Steven-ZYC/int4089-fitness-aid-bot/README.md

<div align="center">

FitCoach AI — Move better. Train smarter.

<br />

[English](README.md) · [简体中文](README_zh_cn.md) · [繁體中文（香港）](README_zh_hk.md)

<br /><br />

**Your movement. Your feedback. Your progress.**

A modular, PC-powered AI fitness coaching prototype built for **INT4089 — Technologies in STEM and AI Education**.

    

**[✨ Features](#features) · [🧭 Architecture](#architecture) · [🚀 Quick start](#quick-start) · [📖 User manual](docs/guide/README.md)**

</div>

---

## Product preview

<div align="center">
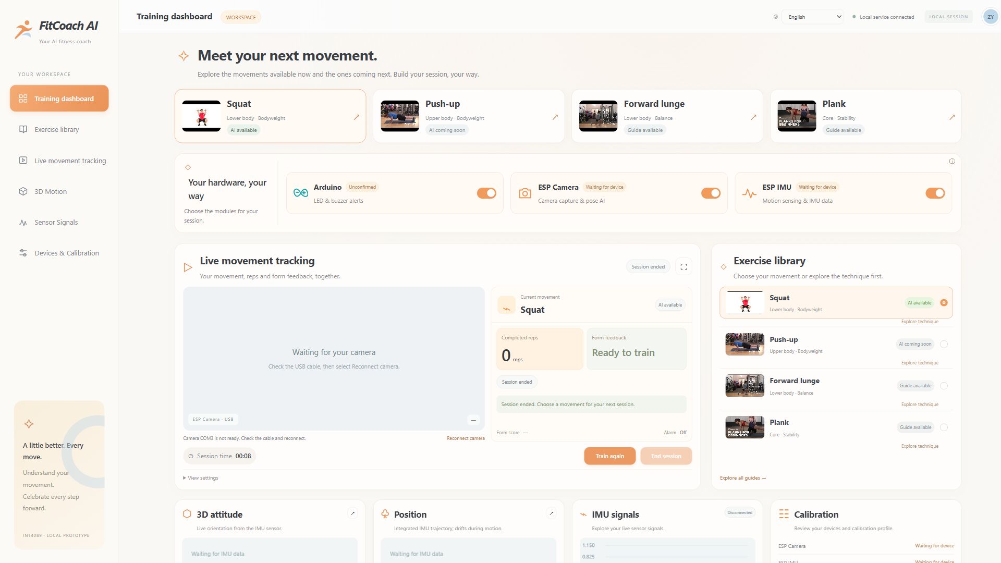
[picture p1: docs/assets/fitcoach-ui-en-16x9.png]
FitCoach AI real application screenshot

<br />
<sub>Actual application screenshot · hardware state shown is not simulated</sub>
</div>

## What you can do

| | Experience | Current implementation |
| :---: | --- | --- |
| 🎯 | **AI squat coaching** | YOLOv8n-pose keypoints, rule-based form feedback, repetition counting and session control |
| 🎬 | **Movement learning library** | Six exercise guides with video previews, step-by-step cues and posture illustrations; **Squat is the only AI-enabled movement** |
| 🎛️ | **Modular hardware configuration** | Independently enable or disable **Arduino alerts**, **ESP Camera**, and **ESP IMU** at the app level |
| 🧭 | **3D orientation & position** | 3D attitude display, motion trace and position reset; displacement is an estimate subject to drift |
| 📈 | **IMU analysis & calibration** | Signal charts, labeled CSV replay, calibration profiles and diagnostics |
| 🌐 | **Multilingual UI** | English, Simplified Chinese and Traditional Chinese (Hong Kong) |

> [!IMPORTANT]
> **Prototype, not a finished fitness product.**

### Movement library

| AI coaching available | Teaching preview / AI planned |
| --- | --- |
| ✅ **Squat** | Push-up · Forward lunge · Plank · Glute bridge · Bird dog |

### Mix the hardware you need

| Module | Role | Can operate independently? |
| --- | --- | --- |
| **ESP Camera** (ESP32-CAM / OV2640) | Captures JPEG frames and sends them to the PC over USB | Camera-based squat coaching does not require live IMU data |
| **ESP IMU** (ESP32-S3 N16R8 + BMI160) | Acquires inertial signals for monitoring and analysis | IMU monitoring/replay may be viewed without camera-based coaching; live BMI160 is pending validation |
| **Arduino alerts** | Drives LED and buzzer from received alarm state | Switchable; **physical alarm delivery** needs the complete CAM → S3 → Arduino path |

App toggles do **not** cut hardware power.

## 🧭 Architecture

```mermaid
flowchart LR
    U([Workout]) --> CAM[ESP32-CAM<br/>OV2640 Camera]
    CAM -->|JPEG frames over USB| PC[PC<br/>YOLOv8n-pose + form rules]
    PC -->|Alarm state over USB| CAM
    CAM <-->|ESP-NOW: alarm + ACK only| S3[ESP32-S3 N16R8]
    IMU[BMI160 IMU] -->|I²C| S3
    S3 -->|One-way UART| Arduino[Arduino]
    Arduino --> LED[LED + Buzzer]
    classDef compute fill:#f9eedb,stroke:#eb9861,color:#303a40;
    classDef sensor fill:#eaf3f8,stroke:#bdd6e8,color:#303a40;
    class PC,Arduino compute;
    class CAM,S3,IMU sensor;
```

**The camera stream is USB-based. ESP-NOW transports only compact alarm commands/acknowledgements—never images.** AI inference runs on the PC, not on the ESP32. Cloud/HPC execution is a future possibility, not a deployed feature.

## 🚀 Quick start

**Requirements:** Windows PowerShell, the project's configured Python virtual environment, and the connected camera board. Serial ports are machine-specific.

```powershell
# From the repository root
powershell.exe -NoProfile -ExecutionPolicy Bypass -File app/run_pose.ps1 -CamPort COM3 -ImuPort COM4 -Action squat
```

Open **http://127.0.0.1:8010**, confirm device status, select **Squat**, align the camera and choose **Start training**. Use `-ImuPort ''` to skip initial IMU connection. `-Action squat` is the only AI action supported by the unified application.

For fresh installation and manual launch options, follow the [PC app guide](app/README.md) and [unified app guide](app/UNIFIED_APP.md). Do not run firmware upload, serial diagnostic and the dashboard against the same COM port simultaneously.

## 🧪 Evidence & current limitations

| Status | Result / validation boundary |
| --- | --- |
| ✅ | Real USB image CRC/decoding and PC pose inference |
| ✅ | Wireless alarm state / ACK / command-expiry tests |
| ✅ | **8.93 FPS** camera USB-only benchmark (not a guaranteed AI end-to-end rate) |
| 🛠️ | BMI160 live data not yet stable; physical alarm output and exercise accuracy require on-device acceptance |

See the [test evidence](docs/validation/2026-11-10-camera-speed-after.json) and [system architecture](docs/architecture/README.md). Position double-integration may drift; yaw lacks an absolute magnetometer reference.

## 📖 Documentation

- [**Illustrated assembly guide / user manual**](docs/guide/README.md) · [English user manual (PDF)](docs/guide/fitcoach-user-manual.pdf)
- [PC application & training workflow](app/UNIFIED_APP.md)
- [Firmware and hardware connections](firmware/README.md)
- [System architecture & protocols](docs/architecture/README.md) · [Documentation index](docs/README.md)
- [Maintenance and contributor rules](AGENTS.md)

<details><summary><strong>Repository layout</strong></summary>

```text
app/                  # Local web app, computer-side pose inference and IMU service
firmware/             # ESP32-CAM, ESP32-S3, Arduino and protocol implementations
models/               # Model tasks and research notes
experiments/          # Historical on-board inference benchmarks
tools/imu-position/   # IMU acquisition, calibration and visualization
docs/                 # Assembly guide, architecture, screenshots and validation
AGENTS.md             # Branch and maintenance rules
```

</details>

---

<div align="center"><sub>FitCoach AI · INT4089 · The Education University of Hong Kong<br/>Built as an educational engineering prototype — designed to help learners understand movement and sensing.</sub></div>
