Steven-ZYC/int4089-fitness-aid-bot/models/README_zh_cn.md

# AI 模型与电脑端分析（Prototype）

负责人：**Zhang Haoyu**；专属分支：**`Feat-Arduino-Haoyu`**（历史分支名，当前任务不以 Arduino 固件为主）。

开始前阅读根目录 [AGENTS.md](../AGENTS.md)，确认身份、本人分支及工作区状态。只在本人分支修改提交；用 PR 申请合并到 `main`。

## 最新任务（2026-10-30 consultation 后）

**AI 推理暂时在团队电脑上运行，不要求把模型部署在 ESP32 上。** 数据由 Dong Yuankun 的双 ESP32 系统提供：ESP32-CAM 采集图像，ESP32-S3 主 ESP 采集 Bosch BMI-series IMU 的运动数据，并负责与电脑的网络通信。

此目录应逐步形成可复现的**数据集选择 → 训练／验证 → 电脑端推理 → 姿势结果输出**流程。未来若原型验证可行，可再考虑迁移至云端 HPC／GPU 服务器；目前不得写成已上线。

## 当前交付要求

1. **任务定义**：先明确要支持的健身动作、姿势异常的判定标准、模型输出（关键点／动作类别／错误类型等）和可观测评价指标；不要只以“人体姿态检测”笼统代替“动作是否标准”。
2. **数据集调查与选型**：对比候选数据集的动作覆盖、姿势标注、许可、规模、可用性及数据质量；记录下载／标注流程、训练／验证／测试划分，避免数据泄漏。无法直接支持姿势正误识别的数据集须说明补标或迁移方案。
3. **模型训练与验证**：建立最低可用 baseline，保存版本、环境、超参数、预处理与验证结果；如尚未跑通就标明未训练，不预报准确率。
4. **电脑端推理服务**：编写可在团队电脑运行的图像输入、推理、后处理与结果输出流程。和 Yuankun 确认网络消息格式及摄像头帧、IMU 时间戳的数据接口。
5. **融合策略与指标**：明确第一版使用图像 alone 还是图像 + IMU 融合；如果融合未实现，需明确标记。记录模型级时延、有效帧率及与系统集成相关的端到端延迟。
6. **交付集成**：给出判断结果的数据结构（含动作、时间戳、置信度／阈值、反馈类型等可用字段）、测试样例与运行说明，让 Yancheng 可以对接 Arduino 的 LED／蜂鸣器提醒。

## 协作接口

- 与 **Dong Yuankun**：约定图像输入格式、IMU 单位和坐标系、时间戳、传输速率／容错、电脑侧接收方法。
- 与 **Zhang Yancheng**：确认原型范围、系统接口与测试场景；输出“姿势正常／需要提醒”等结构化消息供硬件闭环使用。
- 历史 ESP32-S3 板上部署与 RDK X5 NPU 不再是本阶段的交付要求。

本文件是任务说明，**不代表已选定数据集、训练成功、验证模型性能或完成电脑端服务**。不提交可辨识的人像、未授权数据或凭据；模型权重和训练数据根据项目忽略规则及许可管理。
