Steven-ZYC/int4089-fitness-aid-bot/firmware/arduino-uno/README_zh_cn.md

# Arduino：LED 与蜂鸣器

任务状态：**保留的 Arduino 基础控制说明**。

原负责人为 **Zhang Haoyu**；其当前重点已转为[模型训练研究](../../models/README.md)，本文件不再代表他的当前首要任务。
后续硬件任务分工由 Zhang Yancheng 统筹。

历史任务分支：**`Feat-Arduino-Haoyu`**（大小写必须一致）；该分支目前继续用于 Haoyu 的模型训练研究。

开始前先读仓库根目录 `AGENTS.md`，明确确认当前用户身份，并检查当前分支。
身份不明时必须先询问；只有确认本人及专属分支后才能开始修改。
本任务只在自己的分支修改、提交和推送，禁止直接向 `main` 或其他成员分支提交。

## 保留的硬件目标

使用 **Arduino** 接好 LED 和蜂鸣器，并能分别进行基础控制。
本目录目前是任务说明，尚未提供或验证固件与接线。

## 交付与验收

1. 提交清晰的接线记录：器件、实际引脚、电源／地线、必要元件及接线照片或示意图。
2. 提交可烧录的最小示例：LED 能亮灭，蜂鸣器能按指令响起并停止。
3. 记录板上实际运行结果，让其他成员按步骤能够复现。
4. 明确标注哪些内容已实测、哪些仍待确认；不要把预期效果写成实测结果。

## 随交付记录

- 实际 Arduino 板卡型号／版本、LED 类型与蜂鸣器类型。
- 完整引脚映射、供电方式及实际使用的电阻等元件。
- Arduino IDE 版本、开发板选择、板卡包版本及上传端口选择方法。
- 所需库及版本；无额外库时明确写明。
- 从打开工程、编译、烧录到操作 LED／蜂鸣器的复现步骤。
- 已观察到的表现、失败现象和排查方法。

硬件型号、引脚、电压或器件类型尚未确认时，先记录待确认项，不得猜测接线。
Arduino 负责本地 LED／蜂鸣器控制，需与 **ESP32-CAM** 建立硬件连接；另一块 **ESP32-S3 N16R8** 规划作为连接 Bosch BMI-series IMU 和电脑网络的主 ESP。**AI 训练与推理现阶段在团队电脑上进行**，将来原型有效后才考虑云端 HPC。具体 AI 判断结果返回 Arduino 的链路、引脚和电气设计仍待集成验证；旧的 ESP32-S3 板上推理与 RDK X5 方案已不是当前主线。
不要提交 Wi-Fi 密钥、凭据或含可识别人像的照片。
