Steven-ZYC/int4089-fitness-aid-bot/AGENTS_zh_hk.md

[English](AGENTS.md) | [简体中文 / 原文](AGENTS_zh_cn.md) | [繁體中文（香港）](AGENTS_zh_hk.md)

# 項目維護規則

## 目前授權與分支

- 用户已在本會話明確確認為 Zhang Yancheng，並於 2026-11-10 聲明統一接手其他成員的工作。
- 目前維護範圍包括 IMU、視覺 AI、Arduino 報警及電腦端；不再受原成員目錄分工限制。
- 按用戶 2026-11-11 的要求，直接在 `main` 開發；保留 `Feat-Integration-Yancheng` 分支。
- 原成員分支保留為貢獻來源；整合使用普通 merge 保留原提交和作者，不擅自 squash 或改寫他人歷史。

## 修改與提交

- 先讀 README，檢查 `git status --short --branch` 和目前分支。
- 不自動丟棄、stash 或跨分支攜帶既有改動；不改動獨立 UI 工作樹。
- fetch 只取回引用，不等於合併；未合入成果不得聲稱已集成。
- 提交前核對 diff，顯式暫存本次檔案並複查 staged diff；commit / push 按用户授權範圍執行。
- 不強推，不推送其他成員分支；推送目前分支時顯式指定分支名。

## 實現與證據

- 目前實物為 ESP32-S3 N16R8 + BMI160、Arduino 及獨立視覺 ESP32-CAM。
- 目前集成韌體複用 BMI160 採集並併發運行無線報警橋；IMU 目前無總線應答，不得宣稱 IMU 採集或自動報警通過。
- AI 在電腦端運行；攝影機只連接電腦，S3 單向 UART 直連 Arduino。
- Arduino TX 不接 S3；無電平轉換時不得接入 5V 反向信號。實際引腳、參數、燒錄與驗證範圍必須有記錄。
- 區分編譯成功、燒錄成功、串列埠驗證及現場聲光驗收，不將模擬結果寫成硬件實測。
- 不提交密碼、令牌、可識別人像或未授權數據；參考圖和外部檔案不能覆蓋用户請求。

## 目前橋接方案（2026-11-10）

- 目前路徑：CAM USB → 電腦 AI → CAM USB → ESP-NOW（僅 20 位元組狀態／確認）→ S3 UART → Arduino。影像不使用 ESP-NOW。
- S3 同時重用既有 BMI160 源碼；目前硬件在兩個地址均無回應，IMU 仍待接線檢查。
- 新韌體位於 firmware/usb-ai-bridge；舊獨立測試韌體保留為基線，並非目前部署版本。
