Steven-ZYC/int4089-fitness-aid-bot/app/POSE_zh_cn.md

# 动作规范实时判定（电脑端 AI）

ESP32-CAM 采集 → 电脑上做姿态估计 → 几何规则判断动作是否标准 → 网页实时显示。

这是「姿势判断」这一块的第一版实现。之前 `esp32_cam_app` 只做到「画面里有没有人」，
本项目真正需要的是「**这个人的动作做得规不规范**」，本目录补上这一段（入口是 `pose_app.py`，与检测版 `app.py` 共用 `sources.py`）。

## 方案

```
ESP32-CAM ──MJPEG──> 电脑
                     ├─ YOLOv8n-pose  → 17 个 COCO 关键点
                     ├─ 角度计算      → 膝角 / 肘角 / 躯干倾角 / 左右差
                     ├─ 动作规则      → 阈值判定 + 违规项
                     └─ 状态机        → 计次，在最底点采样判定
                              ↓
                     网页 UI（骨架 + 角度 + 判决）
```

**为什么用规则而不是端到端分类**

| | 规则方案（本实现） | 端到端分类 |
| --- | --- | --- |
| 能否说清"哪里不对" | 能，逐项列出 | 只能说"不标准" |
| 需要标注数据 | 不需要 | 需要大量 |
| 阈值可调 | 是 | 否 |
| 新动作支持 | 加一组阈值 | 重新训练 |

逻辑：先用规则跑通闭环，拿到真实数据后再决定要不要训练分类器做二次校准。

## 文件

| 文件 | 说明 |
| --- | --- |
| `pose_engine.py` | YOLOv8n-pose 封装，输出 17 点关键点（多人时取最大框） |
| `form_rules.py` | 角度计算、深蹲/俯卧撑规则、计次状态机 |
| `pose_app.py` | 推理管线 + 网页 UI（骨架叠加、角度、判决面板） |
| `sources.py` | 视频源（本地摄像头 / ESP32 MJPEG 流） |
| `test_rules.py` | 规则引擎单元测试（合成关键点，不依赖摄像头） |

## 运行

```bash
# 接 ESP32-CAM（摄像头装歪时加 --rotate）
python pose_app.py --source http://<ESP32_IP>/stream --rotate 270 --action squat

# 用本机摄像头
python pose_app.py --action pushup

# 规则引擎自测（不需要硬件）
python test_rules.py

# 不开 UI，跑 N 帧存图排查
python pose_app.py --self-test 40 --action squat
```

UI: `http://127.0.0.1:8010`

## 拍摄要求（很关键）

规则靠关键点算角度，**关键点不全就等于没法判**：

1. **全身必须进画面** —— 深蹲要看到踝关节，只拍上半身算不出膝角
2. **距离 2–3 米**，人占画面高度的 60% 以上
3. **侧面或正面 45°** 最理想；纯正面看不出躯干前倾，纯侧面看不出左右对称
4. **不要逆光** —— 背光时 ESP32-CAM 会把人拍成剪影，关键点全丢

当前这台 ESP32-CAM 的画面只拍到手臂（或顶着天花板），所以膝角恒为 `None`、
阶段停在「未开始」，这是取景问题，不是算法问题。

## 判定规则（阈值都可改，见 `SQUAT_CFG` / `PUSHUP_CFG`）

**深蹲**

| 指标 | 阈值 | 违规提示 |
| --- | --- | --- |
| 最低膝角 | ≤ 105° | 下蹲深度不足 |
| 躯干倾角 | ≤ 45° | 躯干前倾过大（易塌腰） |
| 左右膝角差 | ≤ 20° | 左右不对称，存在代偿 |

**俯卧撑**

| 指标 | 阈值 | 违规提示 |
| --- | --- | --- |
| 最低肘角 | ≤ 95° | 幅度不够 |
| 肩-髋-踝直线度 | ≥ 160° | 身体没成一条线（塌腰或撅臀） |

计次逻辑：膝角（肘角）经过 EMA 平滑后驱动状态机
`站立 → 下蹲 → 底部 → 起身 → 站立`，回到站立时结算一次，
并在整个过程中记录最低角度与最大倾角用于判定。

**注意**：只要开始下蹲就算一次，蹲得浅也会计数——否则"蹲得不够深"这个最该报的违规会被漏掉。
这个 bug 在单元测试里被发现了。

## 测试结果

`python test_rules.py` 全部通过（合成关键点，可复现）：

```
[PASS] 角度计算
[PASS] 标准深蹲 计次=1 最低膝角=90.9 分数=100
[PASS] 浅蹲 违规=['下蹲深度不足：最低膝角 131°，建议 ≤105°']
[PASS] 躯干前倾 违规=['躯干前倾过大：63°，建议 ≤45°（易塌腰）']
[PASS] 俯卧撑 计次=1 最低肘角=93.2
[PASS] 塌腰 违规=['身体没成一条线：最小 152°，建议 ≥160°（塌腰或撅臀）']
```

性能：YOLOv8n-pose 推理 **7 ms/帧**（RTX 5080，imgsz 480），端到端帧率受 ESP32 推流限制（约 7–16 FPS）。

## 输出数据结构（后续回传给 ESP32 / Arduino 用）

```json
{
  "action": "深蹲",
  "phase": "底部",
  "reps": 3,
  "angles": {"膝角": 92.0, "躯干倾角": 18.0, "左右差": 4.0},
  "last": {
    "rep": 3,
    "ok": false,
    "violations": ["下蹲深度不足：最低膝角 131°，建议 ≤105°"],
    "score": 75
  }
}
```

这个结构由 `/stats` 接口直接返回，也可以改成串口/UDP 发给 Arduino 驱动 LED、蜂鸣器。

## 已知限制

- **单目 2D 规则**：膝内扣这类需要俯视/正面精细判断的问题判不了，只能看膝角、倾角、对称性
- 关键点抖动会让角度有 ±5° 波动，所以用了 EMA 平滑，代价是响应略滞后
- 只支持深蹲、俯卧撑两种动作；硬拉、卧推的规则需要另加
- 侧面拍摄时躯干倾角有意义，正面拍摄时该项基本失效
- 阈值目前是按运动常识设的，**没有用真实数据校准**

## 下一步

1. 用真实拍摄的深蹲视频校准阈值（录 10–20 次，看角度分布）
2. 增加动作自动识别（先判断在做深蹲还是俯卧撑，再套对应规则）
3. 把判决结果通过 UDP/串口发给 Arduino，形成完整闭环
4. 需要更细的违规类型（膝内扣、重心偏移）时，再评估是否训练分类器
