Steven-ZYC/int4089-fitness-aid-bot/firmware/esp32-camera/PROGRESS.md

# Yuankun 任務與進度

更新日期：2026-11-05。分支：`Feat-Esp-Yuankun`。本次成果交接見 [HANDOFF.md](HANDOFF.md)；Git 提交與遠端版本以分支記錄為準。

**歷史第 1–4 步及 11-04 的 Normal 並發檢查已通過；第 5 步未完成，IMU 排查已請組長接手。** 11-05 網關版的專用 Wi-Fi／TCP 控制 5 次及空閒重連後 1 次回覆通過，見 [網絡結果](WIFI_GATEWAY_RESULT.md)；照片／IMU 的 Wi-Fi 傳輸未測。之後 IMU 初始化故障，早期身份可讀但喚醒陀螺儀寫入失敗；用戶最新重新接線後，網關版連最初的身份讀取亦未成功。完整斷電及 100ms 等待測試未恢復，詳見 [IMU 排查](BMI160_RECOVERY.md)。

**目前板上版本：** BMI160_Bus_Check_v1 獨立診斷程式，編譯／上傳校驗及 COM9 的版本讀回通過。用戶已按正面位置確認 VIN 留空、六線全部吻合；16:09 三輪探測在 0x68／0x69 均無應答，身份讀取失敗，停在 INITIAL_ID，尚未執行重設／加速度計／陀螺儀配置寫入，沒有六軸資料。詳見 [分段診斷](BMI160_BUS_DIAG.md) 及 [最新排查](BMI160_RECOVERY.md)。原成功映像及網關來源保留，現在未運行網關。根因未確認，不能直接判定接線錯誤或模組損壞；本輪未切換電腦網絡或刷寫 CAM。

## 器材盤點

| 器材 | 已知證據 | 待確認 |
| --- | --- | --- |
| ESP32-S3-N16R8 主板 | 16MB Flash／8MB PSRAM 自檢、IMU 基線通過；COM9／CH340 的 ESP-NOW 文字、圖片重組及 USB 導出通過 | 長時間 IMU／圖片並發及網絡；原生 USB 無輸出原因未定位，未做全容量記憶體壓力測試 |
| 舊 ESP32-CAM | COM11 的 OV2640／4MB Flash／2MB PSRAM、新幀檢查、ESP-NOW 文字及三個圖片案例通過 | 固定取景、畫質／長時間測試、長時間 IMU 並發採集 |
| 紫色 BMI160 標示模組 ×1 | 身份、六軸靜止／運動、照片參考加速度方向、順時針負 Z、獨立零偏驗證；多段實測約 49.73 Hz | X／Y 角速度各自的定向標定、加速度多姿態／比例／溫度校準、長時間穩定性；無廠商資料，未量測電壓與上拉阻值 |
| 藍色 GY-801 ×3 | 新照片和你提供的數量 | 備用；未逐塊驗證晶片型號或讀值 |
| Arduino 與提醒器件 | 組長架構要求 | 是否在手邊、具體通信／電平轉換及控制接線 |
| 接線用品 | 你確認有杜邦線和麵包板 | 按實物接點選可牢固插接的線材 |

## 任務清單與完成條件

| 步驟 | 狀態 | 做甚麼、為甚麼 | 甚麼證據才可標完成 |
| --- | --- | --- | --- |
| 0 | **已完成：盤點與選型** | 按現有器材選紫色 BMI160；圖像與 AI 分工保持組長新方案 | 照片／數量已記錄，[選型理由](IMU_SELECTION.md) 已寫明；不代表電路已測 |
| 1 | **已完成：基本自檢** | 新 S3 獨立自檢，先確保主控可燒錄與輸出資料 | COM9 確認 S3、寫入校驗通過、兩次週期報告讀回 16MB／8MB，見 [實測結果](S3_TEST_RESULT.md) |
| 2 | **已完成：接線與身份通訊** | [六線接法](BMI160_WIRING.md) 經用戶核對；COM9 燒錄成功，GPIO4／GPIO5 I²C 通訊 | 連續兩次 `ACK address=0x68 CHIP_ID=0xD1`，0x69 無回應，見 [實測結果](BMI160_TEST_RESULT.md) |
| 3 | **歷史通過；11-05 初始化回歸待恢復** | raw／g／°/s、量程、兩種本地時間、約 49.73 Hz、靜止／運動、照片方向與零偏方案均有證據 | 照片下左側抬高→ax 增、1 端抬高→ay 減、面朝上→az 正；順時針主要負 gz，獨立零偏驗證通過。完整精密校準及未測項另列，不宣稱完成，見 [續記](BMI160_AXES_CALIBRATION.md) |
| 4 | **已完成：基礎單張圖片及反向訊息** | [相機](CAM_RECHECK_RESULT.md)、[文字](DUAL_ESP_TEXT_RESULT.md) 及 Normal／DropAck／CorruptPacket 三個圖片案例通過 | 3 張 640×480 JPEG 經 S3 重組、USB 導出、三端 SHA256 相同及解碼成功；圖像版反向回覆均通過。兩個受控故障各重試一次，見 [實測](DUAL_ESP_IMAGE_RESULT.md)；不代表持續視頻或長期可靠性已驗收 |
| 5 | **待組長接手：Wi-Fi 控制／TCP 重連通過；IMU 故障未恢復** | 新網關 5 條正常測試及重連後 1 條回覆均通過；見 [網絡結果](WIFI_GATEWAY_RESULT.md)。11-04 並發基線 496 筆、49.7338 Hz 保留 | 先恢復 IMU 身份讀取及初始化，接著驗證照片／IMU Wi-Fi 傳輸；固定鏡頭、AP 斷線／重連、長時間及串流尚未驗收 |
| 6 | 未開始／需協作 | 與 Haoyu 對齊時間、單位、資料格式與感測器固定位置 | 共同格式、時間戳映射、動作範圍及固定位置記錄；Haoyu 能實際讀取，不把兩板 uptime 視為同一時鐘 |
| 7 | 未開始／需協作 | 與 Yancheng 跑通電腦 → S3 → CAM → Arduino 的結果回傳與完整演示 | 安全電平與接線核實；LED／蜂鳴器按訊息工作；記錄延遲、失敗情況和完整復現步驟 |

## 已有證據

- S3 自檢草圖：本機 `esp32 3.3.12`、Arduino CLI `1.5.1` 已編譯，現已燒錄並實際運行。完整結果見 [S3_TEST_RESULT.md](S3_TEST_RESULT.md)。
- 已在 COM9 用指定 ESP32-S3 型號讀取晶片資訊，後續程式亦回報 `chip=ESP32-S3`；16MB Flash／8MB PSRAM 和兩次 READY 均已讀回。
- 舊 CAM：10-23 已保存兩張可讀 JPEG，見 [歷史記錄](USB_CAMERA_DEMO.md)。這是歷史基線，不代表今天所有連線仍正常。
- IMU：已有器材、選定 BMI160，2026-11-03 已完成用戶逐線確認與實機身份通訊。
- BMI160 身份讀取草圖：Arduino CLI 1.5.1／esp32 3.3.12 已編譯並成功上傳；COM9 兩次完整身份報告均通過，歷史證據見 [身份結果](BMI160_TEST_RESULT.md)。
- S3 曾運行 BMI160_SixAxis_v2，已完成靜止／自由轉動測試。兩段各 747 組、約 49.73 Hz，格式及診斷錯誤為零，沒有 >30 ms 讀取空檔；原始 CSV 及統計保留在 [六軸結果](BMI160_SIX_AXIS_RESULT.md)。該獨立基線沒有套用校準；本輪合併版另見下方 01:04 記錄。
- 本輪用戶明確確認晶片面向上、七針接線邊遠離用戶，完成固定方向平放 500 組基準。記錄工具已修正啟動等待與記錄時間分開計算；[方向與校準續記](BMI160_AXES_CALIBRATION.md) 保留測試條件、實測和未完成項目。
- 遠端抬高 500 組 ax 約 +0.759 g；請求右側抬高的 501 組卻主要為 ax 約 −0.773 g。兩段傳輸通過，但物理方向未充分核實，未當成 X／Y 兩個獨立方向驗收。
- 另錄 500 組獨立桌面靜止資料，電腦端使用先前基準偏置修正，驗證集三軸修正均值約為 [+0.02238, +0.00339, +0.00015] °/s，原型零偏檢查通過。S3 仍輸出未補償數據，沒有更改硬件補償寄存器。
- 新照片證實七針接線側在照片左方，並以照片上端 1、下端 30 作參考：新平放 500 組、1 端抬高 500 組、接線側長邊抬高 501 組均通過，X／Y 方向已區分。首筆完整資料前的串口半行另列 startup_fragments，記錄開始後仍嚴格檢查壞行。
- 操作卡片期間的順時針試錄 90 秒、4479 組約 49.73235 Hz，無格式／診斷錯誤、序號跳變或 >30 ms 間隔；主動作落在約 52–54 秒，主要負向 gz。示範扣偏置積分約 −26.55°，不作精密角度標定。
- CAM 已在 COM11 重連，先用原程式取得 3 張可解碼 JPEG；因舊協議缺少畫面時間，未當作新畫面證據。原始人像只留在本機接收目錄。
- 另編譯並上傳 ESP32CAM_USB_Check_v1，讀回 OV2640 PID 0x0026／VER 0x42、4MB Flash／2MB PSRAM。新固件 3 次分別 9,253／15,545／9,522 bytes，seq 1／2／3；每次丟棄 1 張較舊幀，首 DMA 時間在命令之後，META／IMG／DONE 及點陣圖解碼均通過。桌面物件樣張及逐次統計見 [CAM 重測](CAM_RECHECK_RESULT.md)。第 3 張取景又朝天花板，不作固定場景穩定性證據。
- 22:20 完整通訊自檢：S3 COM9 與 CAM COM11，ESP-NOW 頻道 1，48-byte 訊息，正常雙向各 20／20 次，零重試／失敗；各故意漏一個 ACK 均重試一次並辨認重複序號。42 條邏輯訊息逐條配對兩端記錄，CRC／佇列／API 錯誤計數無增加。兩次較早未完整通過的嘗試分開保留，詳見 [結果](DUAL_ESP_TEXT_RESULT.md)。
- 約 23:00 已將 DualESP_Image_Check_v1 分別上傳到 CAM COM11、S3 COM9 並校驗；23:03 讀回新版本、240-byte 包／200-byte 資料區、頻道 1、2MB／8MB PSRAM 及彼此配對編號。只發 INFO 和 TEST_ONLY CONTROL，1 次嘗試回覆成功，未發 CAPTURE；`image_transfer_tested=false`。原始記錄見 [圖片準備](DUAL_ESP_IMAGE_RESULT.md)。
- 11-04 00:32 用戶確認鏡頭放穩後，Normal／DropAck／CorruptPacket 全部通過，分別 14,755／12,160／12,153 bytes、74／61／61 片、0／1／1 次重試。每張均三端 SHA256 相同、解碼 640×480，反向 TEST_ONLY 均一次回覆；原圖及兩端日誌見 [圖片實測](DUAL_ESP_IMAGE_RESULT.md)。11-03 預檢的 false 標記保留，沒有改寫為實拍證據。
- 11-04 01:04 S3 合併版 Normal 實機通過：496 筆序號連續，49.7338 Hz，最大 S3 間隔 21.946 ms、sensor time 差 555 ticks，無讀取／設定錯誤或溢出。JPEG 10,031 bytes／51 片、零重試，三端 SHA256、640×480 解碼和反向 TEST_ONLY 通過。照片實為天花板／空調，沒有當成桌面或動作取景驗收；見 [並發結果](IMAGE_IMU_RESULT.md)。

## 交接與下一步

最新診斷（11-05 16:09）：獨立診斷程式上板、版本讀回通過。0x68／0x69 各 3 次實際探測 stop_code=2，均未取得身份資料；RUN_INIT 停在 INITIAL_ID，未執行後續配置寫入。原始記錄見 [分段診斷](BMI160_BUS_DIAG.md)。15:17／15:50 原成功固件的失敗重試作為歷史記錄保留。

COM9 可讀回獨立診斷版本 INFO；現在的故障已細分為未取得身份應答，不把先前身份可讀或 GYRO_WAKE_WRITE 的結果當作這次仍發生於同一階段。SDA／SCL 數位讀取均為高，只是邏輯觀察，不代表量到供電電壓。完整記錄見 [BMI160_RECOVERY.md](BMI160_RECOVERY.md)。

用戶確認無法拍背面帶線近照，**取消這個拍攝要求，不為拍照拆線**。已按 [正面位置表](BMI160_WIRING.md) 確認 VIN 留空及六線全部吻合。位置核對完成，不再重複要求整套重接；尚未量測實際供電／接點導通。用戶已確認沒有萬用表，並要求保存／推送現有成果、由組長接手排查。本輪停止硬件測試；組長可安排供電／導通量測或使用現有 GY-801 做獨立通訊對照，兩者均未執行。詳見 [交接文件](HANDOFF.md)，不把 GY-801 當成已驗收的 BMI 替代品。

原成功映像已驗證保留且 SHA256 與 11-04 相同；它在今天對照時仍失敗，隨後才替換為目前的獨立診斷程式。CAM COM11 保留圖片版；S3 當前未啟動 Wi-Fi／ESP-NOW，不能沿用先前已配對的狀態。串口工具均已結束，沒有持續採集或人工動作要求。

第 5 步仍進行中。Wi-Fi 控制／空閒 TCP 重連及 11-04 歷史成功證據保留；新網關圖像／IMU 網絡傳輸、長時間、精密校準、跨板校時及 AI／Arduino 仍待驗證。
## 後續對話與學習方式

這是用戶要求的教學節奏：每一步先說「目的、原因、操作、成功時看到甚麼」，每輪結尾固定報告：

1. **已完成**：只列有文件、編譯、照片或硬件輸出支持的項目，分清軟件準備與實機驗證。
2. **目前**：當前步驟及尚缺的證據；有錯誤就先解釋它表示甚麼。
3. **下一步**：只給當下可操作的一個小步驟。

收到新輸出或硬件資訊後更新此檔；沒有新測試證據時不自動推進狀態，不以估計百分比代替驗收。

交付授權更新（2026-11-05）：用戶已明確要求把目前成果保存並推送至本人 Feat-Esp-Yuankun，附 IMU 問題交接。這取代先前本輪「暫不保存」偏好；僅限本次成果交付，後續另行修改仍依當時授權及根 [AGENTS.md](../../AGENTS.md) 執行。
