Steven-ZYC/int4089-fitness-aid-bot/firmware/esp32-camera/BMI160_RECOVERY.md

# BMI160 初始化回歸排查：2026-11-05

身份：Dong Yuankun。分支：`Feat-Esp-Yuankun`。交付與目前未完成項目見 [HANDOFF.md](HANDOFF.md)。

**COM9 已恢復；IMU 仍未恢復有效六軸採集。** 這是 11-04 成功之後的新故障，不能把先前 496 筆的成功當作目前正常。Wi-Fi 控制及空閒 TCP 重連的成功證據另見 [網絡結果](WIFI_GATEWAY_RESULT.md)。

## 已實際做過甚麼

1. 用戶重新插牢 S3 的 CH340C 旁 COM 接口和電腦端；Windows 再次出現 COM9／CH340，能讀到網關 INFO。
2. 完整斷電／重新插牢之後，啟動仍讀到 BMI160 0x68／0xD1；失敗階段為 `GYRO_WAKE_WRITE`，代表送出喚醒陀螺儀命令時 I²C 寫入回傳非零。未建立採集工作，sample count=0、fault=4。
3. 新增只允許初始化失敗、尚無採集工作時執行的 `IMU_BUS_DIAG`。所有寫入只是既有的軟重設及 PMU 命令，沒有寫入 NVM／eFuse。
4. 同一故障總線上比較 20ms 與 100ms 等待上限；結果見下表。100ms 案例接在已失去通訊的狀態之後，不能當成乾淨的獨立對照。
5. 再將開機流程直接改用原六軸基線的 100ms，重新編譯／上傳／重啟。INFO 明確讀回 i2c_timeout_ms=100，但仍 imu=FAULT、fault=4、total_samples=0，未恢復。

| 案例 | 實測 |
| --- | --- |
| 20ms：軟重設 0xB6 | code=0，529 µs |
| 20ms：喚醒加速度計 0x11 | code=0，359 µs |
| 20ms：喚醒陀螺儀 0x15 | code=4，6,987 µs；之後身份／PMU／錯誤暫存器均讀取失敗 |
| 接續的 100ms：軟重設 | code=4，99,722 µs；身份／PMU／錯誤暫存器讀取失敗 |
| 從重新開機即用 100ms | 仍初始化故障，沒有有效六軸資料；本段 INFO 未保留失敗點之前的全部開機行，不將它說成已重新逐點證明同一階段 |

Wire code=4 是本機 core 3.3.12 的一般其他錯誤，明確 timeout 對應 code=5；不能單憑 code=4 判定是逾時，也不能據此判定模組壞了。100ms 從開機測試仍未恢復，尚無證據支持「單純把等待時間改長便修好」。

上述網關診斷來源保留 100ms，沒有宣稱它是已驗證修復；完整照片／IMU 工具會拒絕 FAULT。後續已恢復 11-04 原成功映像，現在板上版本及最新結果見文末「原成功固件對照」。

## 原始證據

- [20／100ms 總線記錄](evidence/2026-11-05/imu_bus_compare_20261105.txt)、[該版構建摘要](evidence/2026-11-05/imu_bus_compare_build_20261105.json)、[上傳日誌](evidence/2026-11-05/imu_bus_compare_upload.txt)。
- [100ms 重新開機記錄](evidence/2026-11-05/imu_100ms_startup_20261105.txt)、[該版構建摘要](evidence/2026-11-05/imu_100ms_startup_build_20261105.json)、[上傳日誌](evidence/2026-11-05/imu_100ms_startup_upload.txt)。

## 下一個有用的檢查

用戶確認目前安裝方式無法拍背面帶線近照，取消這個要求，不為拍照拆線。已依 [正面位置核對表](BMI160_WIRING.md) 完成 VIN 留空及六線全部吻合的用戶核對；不再重複要求整套接線核對。最新獨立診斷仍未取得身份應答，見文末 16:09 結果；下一步視有無萬用表，量測實際供電／接點，或使用現有 GY-801 做通訊對照。這兩種後續檢查尚未執行。下方早先「補背面照」及逐線核對的敘述保留作排查歷史，已由本段替代。

不以軟件輸出當成電壓量測，不宣稱已排除供電、接點、驅動或模組問題。保留原接線狀態作檢查；無需先換型號或購買新器材。

參考：[Bosch BMI160 DS000-09](https://www.bosch-sensortec.com/media/boschsensortec/downloads/datasheets/bst-bmi160-ds000.pdf) 的 PMU 命令與等待時間；[Arduino ESP32 Wire 實作](https://github.com/espressif/arduino-esp32/blob/3.3.12/libraries/Wire/src/Wire.cpp) 的回傳碼。本次測量本身以所附原始記錄為準。
### 收到新接線照片後

[11-05 新正面接線照](evidence/2026-11-05/bmi160_wiring_front_20261105.jpg) 可見 S3 的 GPIO4／GPIO5 接頭，位置看起來與程式相符；這只是照片觀察，沒有量測電氣連續性。紫色模組是晶片正面，VIN／3v3／GND／SCL／SDA／CS／SA0 的背面字樣不可見，不能僅憑線色確定各端對應，也沒有據此宣稱供電接錯或接對。

下一步只需補 BMI160 背面帶接線近照：S3 USB 拔掉，保持六條線原樣，輕抬紫色小板露出印字的一面，勿拉緊線；看清標示與每個插頭的位置後才能進一步核對。S3 端已有這張照片可參考。此輪沒有再次上電、上傳、採集或切換 Wi-Fi。
### 原成功固件對照（最新）

用戶重新接線後，網關診斷版這次在 INITIAL_ID 就失敗，兩個位址皆未讀取成功，原始記錄另存。隨後保持現有接線，直接恢復 11-04 成功的同一份 S3_Image_IMU_Check_v1 應用映像；SHA256 與成功摘要完全相同：9E169486B66DF3350139B59AE4D441D116992D8ADDB38EA19B1D95FB57726779，909,424 bytes。寫入校驗通過，沒有重新編譯，也沒有改 CAM。

上傳後第一次開 COM9 時該端口暫時消失；後續重新辨認到 CH340 COM9，讀到正常 Flash 啟動及 `FATAL role=S3 reason=IMU_INIT`。因此基線應用已恢復、USB 串口正常，但 IMU 初始化仍未通過。基線只輸出一般 IMU_INIT，不能把它說成已在此版本重新證明 GYRO_WAKE_WRITE。

這個對照顯示當前條件下舊成功映像也失敗；原因仍未確認，不能直接斷定新程式、接線錯誤或模組損壞。沒有量測電壓或電氣連續性。下一步需要目前 BMI160 印有 VIN／3v3／GND／SCL／SDA／CS／SA0 的背面帶線近照，保留當前接點供核對。

當前板上為 S3_Image_IMU_Check_v1 基線，已在 IMU 初始化停止；Wi-Fi 網關來源保留在本機，但不是現在板上運行版本。這輪沒有新的拍照、六軸或網絡資料驗收。

證據：[對照摘要](evidence/2026-11-05/known_good_baseline_recheck_20261105.json)、[基線上傳校驗](evidence/2026-11-05/known_good_baseline_restore_upload_20261105.txt)、[實際啟動記錄](evidence/2026-11-05/known_good_baseline_recheck_20261105.txt)。

### 15:17 再次連線重試

按用戶要求保留現有接線及板上原成功基線，再以 COM9 讀取 Flash 資訊並重啟 S3，沒有重刷固件、切換 Wi-Fi 或操作 CAM。讀取／重啟工具成功結束；接著在 115200 串口讀到 `FATAL role=S3 reason=IMU_INIT`。COM9、COM11 仍被 Windows 辨認到。

因此 USB 通訊可用，但本次 IMU 初始化仍未通過，沒有新增六軸數據；這次是重啟，不是完整斷電測試。一般 IMU_INIT 無法指出具體失敗寄存器，根因仍未確認。第 5 步先恢復 IMU；下一個有用證據仍是 BMI160 背面帶線近照，以看清每個插頭所對應的腳位名稱。

證據：[本次摘要](evidence/2026-11-05/imu_retry_20261105_071708_398Z.json)、[本次原始記錄](evidence/2026-11-05/imu_retry_20261105_071708_398Z.txt)。

最新目視進度：用戶按晶片面朝前、七針在上、五針在下的方向，確認最右 VIN 留空。取消補背面帶線照要求；下一步保持 USB 拔掉，沿線核對右數第 2 腳 3v3 與右數第 3 腳 GND 分別接到 S3 3V3／GND。僅為用戶目視回報，未測電壓／導通，沒有新上板測試。

### 15:50 供電腳位核對後重試

用戶確認 BMI160 3v3 → S3 3V3、GND → S3 GND 都吻合，最右 VIN 留空。COM9／COM11 均被 Windows 辨認；COM9 讀取 Flash 資訊並重啟成功，接著仍讀到 `FATAL role=S3 reason=IMU_INIT`，沒有重刷固件或採集到六軸。這是接線位置目視核對，不是電壓／導通量測，也未取得完整斷電確認。根因未確認。

下一步保持 USB 拔掉，依正面位置一次核對剩下四根線：左 1 SA0 → GND、左 2 CS → 3V3、左 3 SDA → GPIO4、左 4 SCL → GPIO5。不要求背面照片，不先改接線。

證據：[摘要](evidence/2026-11-05/imu_power_checked_retry_20261105_075029_880Z.json)、[原始記錄](evidence/2026-11-05/imu_power_checked_retry_20261105_075029_880Z.txt)。

### 16:09 六線位置全部核對後的獨立診斷（目前）

用戶明確回覆剩餘四線都吻合，連同 VIN 留空及 3v3／GND，已完成依正面位置表的全部接點核對。不再要求重複整套核對或拍背面帶線照；尚未量測電壓或導通。

新增 BMI160_Bus_Check_v1，只使用 Wire 和串口，沒有相機、Wi-Fi 或 ESP-NOW。編譯 310,479 bytes、靜態變數 23,884 bytes；應用映像 310,624 bytes。COM9 上傳校驗通過，INFO 兩次讀回版本，bus_ready=1、initialized=0。

| 本次檢查 | 結果 |
| --- | --- |
| 0x68 實際 STOP 探測 | 3 次皆 stop_code=2，身份讀取均 received=0 |
| 0x69 實際 STOP 探測 | 3 次皆 stop_code=2，身份讀取均 received=0 |
| SDA／SCL 數位觀察 | 3 輪開始均 1／1；不是電壓量測 |
| RUN_INIT | pass=0、stage=INITIAL_ID；因此未執行軟重設／加速度計／陀螺儀／配置寫入 |
| 六軸採集 | 未執行，0 筆；不能稱為恢復 |

此輪結果是「未取得身份應答」，不能沿用早先身份可讀後 GYRO_WAKE_WRITE 失敗的階段，也不能單憑它判定模組損壞。接點位置吻合仍未證明實際供電、導通或上拉正常。

目前 S3 保留 BMI160_Bus_Check_v1，串口工具已關閉；CAM 未刷寫，沒有切換電腦 Wi-Fi。11-04 原成功映像已重新核對 SHA256 並保留。下一步已詢問是否有萬用表：有則量模組實際電源／接點，沒有則用現有藍色 GY-801 做獨立通訊對照，先不購買新器材；這些後續測試均尚未執行。GY-801 對照不是已驗收的 BMI 替代方案。

[診斷指南與命令](BMI160_BUS_DIAG.md)；證據：[構建／實測摘要](evidence/2026-11-05/bmi160_bus_build_20261105_080905_504Z.json)、[完整串口記錄](evidence/2026-11-05/bmi160_bus_diagnostic_20261105_080905_504Z.txt)、[上傳校驗](evidence/2026-11-05/bmi160_bus_upload_20261105_080905_504Z.txt)。

## 交接決定（2026-11-05）

用戶已確認沒有萬用表，明確要求將目前已完成內容與 IMU 問題保存、推送到本人分支，請組長接手；本輪停止進一步硬件操作，不再要求用戶繼續重接／重試。故障仍未修復，組長是否及如何接手尚待安排。[HANDOFF.md](HANDOFF.md) 集中列明已完成成果、目前兩板版本、六線表、完整證據、重現方法及尚未完成事項；它取代前文對用戶的待辦要求。
