Steven-ZYC/int4089-fitness-aid-bot/firmware/esp32-camera/IMU_SELECTION.md

# 現有 IMU 選型：第一版使用紫色 BMI160

更新日期：2026-11-03。負責人：Dong Yuankun。分支：`Feat-Esp-Yuankun`。

## 選擇

**從目前已有器材中，選紫色、絲印 BMI160 的模組作為第一版運動資料來源。** 已完成 0x68／0xD1 身份、六軸靜止／運動、照片參考加速度方向、順時針主要負 Z 及電腦端獨立零偏驗證，基礎採集驗收通過；詳見 [方向與校準結果](BMI160_AXES_CALIBRATION.md)。完整精密校準等另列後續。

你補充的新資訊取代先前「沒有 IMU」的記錄：現有藍色 GY-801 三塊、紫色 BMI160 標示模組一塊，另有新 ESP32-S3 N16R8 和舊 ESP32-CAM。

| 器材 | 照片與數量證據 | 第一版處理方式 |
| --- | --- | --- |
| 藍色 GY-801，多晶片模組 | 背面 GY-801 清晰可見；正面有 345B 字樣，與 ADXL345 標記相符，但其餘晶片型號及整塊模組電路尚未核實。三塊數量由你提供 | 保留備用；若後續確實需要多點運動量測，再逐塊識別與評估 |
| 紫色 BMI160 標示模組 | 正面 BMI160 絲印清晰；背面有 VIN、3v3、GND、SCL、SDA、CS、SA0 等標示。一塊數量由你提供；已讀到 0xD1 及六軸資料 | **選用**；身份與六軸靜止／自由轉動基線通過，接著確認軸向及校準 |

不能只依 GY-801 名稱，直接套用網路上某一版的晶片組合、原理圖或電壓範圍。照片中的 BMI160 絲印同樣不是晶片功能驗證；最終仍以 ID 和實際讀值為準。

## 為甚麼適合這個項目

1. **符合組長要求。** 最新方案指定 Bosch BMI-series IMU；BMI160 正屬此系列。
2. **量測內容正好對應第一版需要。** BMI160 在同一晶片內整合三軸加速度和三軸陀螺儀，能提供身體某一部位的運動資訊；攝像頭繼續提供圖像，電腦完成 AI 分析。
3. **單顆器件的起步整合較簡單。** 官方文件提供 I²C／SPI 介面、加速度與陀螺儀同步、FIFO 和感測器時間資訊。先把一顆的資料讀對，比一開始處理多顆不同晶片更容易追查錯誤。這是工程複雜度判斷，不是已量測的速度或精度比較。
4. **三塊數量不等於第一版效果更好。** 多塊感測器只有在明確需要多個身體部位的資料時才有價值，也會增加固定位置、校準、位址和時間對齊工作。第一版先用一顆建立可重現基線。

官方規格：見 [Bosch BMI160 datasheet，第 2–3 頁](https://www.bosch-sensortec.com/media/boschsensortec/downloads/datasheets/bst-bmi160-ds000.pdf)。藍板疑似加速度計可對照 [Analog Devices ADXL345](https://www.analog.com/en/products/adxl345.html)；這份晶片規格不代表整塊 GY-801 的所有元件已確認。

## 初學者先理解「六軸」

- 加速度計輸出 `ax, ay, az`：沿感測器三個方向的加速度資訊；靜止放在桌面時仍會量到重力相關讀值，並非三個數都應為零。
- 陀螺儀輸出 `gx, gy, gz`：繞三個方向的角速度，描述轉動有多快。角速度不是直接量出的關節角度。
- 「六軸」是以上六個量測通道，並非能同時量到六個身體部位。
- 單顆 IMU 只反映它固定位置的運動，不能單獨還原全身骨架或保證知道膝關節角度。它提供的是圖像 AI 之外的輔助資料。
- BMI160 本體沒有整合磁力計；第一版不把長時間穩定的絕對朝向當作已具備功能。需要姿態角時，後續才加入融合、偏置處理並驗證漂移。

實際固定在哪個部位，等 Haoyu／Yancheng 確認目標動作後決定；先在桌面完成電子讀值測試。

## 接入前與第一個驗收點

**S3 基本自檢於 2026-10-31 通過，BMI160 身份通訊於 2026-11-03 通過。** 接法為 SDA＝GPIO4、SCL＝GPIO5，使用模組 3v3 電源軌、CS 接 3V3、SA0 接地，見 [逐針接線表](BMI160_WIRING.md)。用戶已逐線確認；實測連續兩次在 0x68 讀到 0xD1。尚未量測上拉電阻與供電電壓數值。

- 紫色板同時標 VIN 和 3v3，沒有廠商原理圖，不能假定 VIN 允許 5V。本次採直接供應標示 3v3 電源軌的方案，VIN 留空，避免依賴未知穩壓器的輸入規格；實際供電、上拉和接線仍需核對。
- Bosch 文件列出的晶片 VDD 為 1.71–3.6V、VDDIO 為 1.2–3.6V；這是晶片規格，不是這塊未知廠商轉接板 VIN 的規格。需先確認模組供電與 3.3V 邏輯相容，再接到 ESP32-S3。
- I²C 是主控與感測器溝通的一種介面，使用 SDA（資料）和 SCL（時鐘）。核對供電、GPIO、CS／SA0 狀態和上拉後才通電。
- BMI160 的 I²C 7-bit 位址依 SDO／SA0 狀態為 `0x68` 或 `0x69`；讀取寄存器 `0x00`，預期 `CHIP_ID = 0xD1`。I²C 位址和 CHIP_ID 是兩個不同概念。
- 收到 `0xD1` 表示 ID 與預期相符，不等於已驗證量測精度、模組可靠性或產品真偽。接著仍要驗證六軸值會隨動作合理改變。

地址和 CHIP_ID 可核對 [Bosch 官方驅動常數](https://github.com/boschsensortec/BMI160_SensorAPI/blob/master/bmi160_defs.h) 及上述 datasheet 第 49、93 頁。

第一版採樣計劃：先讀六軸原始數據，記錄 `sample_seq`、S3 本地時間戳、量程和單位。初始目標 50 筆／秒，實際採樣頻率和丟樣必須量測；先做靜止與逐方向轉動測試，再討論濾波與人體固定。不能把 S3 和攝像頭各自的開機時間戳直接當成同一時鐘。

## 目前進度

選型、S3 自檢及 IMU 基礎採集驗收完成；約 49.73 Hz 六軸、照片參考方向及初步零偏均有證據，見 [結果與保留項目](BMI160_AXES_CALIBRATION.md)。下一步重連 CAM，完整精密校準與整合仍待後續工作。

完整任務和每步完成條件見 [PROGRESS.md](PROGRESS.md)。開始操作新板見 [S3_BRINGUP.md](S3_BRINGUP.md)。
