Steven-ZYC/int4089-fitness-aid-bot/docs/assets/fitcoach-ui-zh-cn-16x9.png

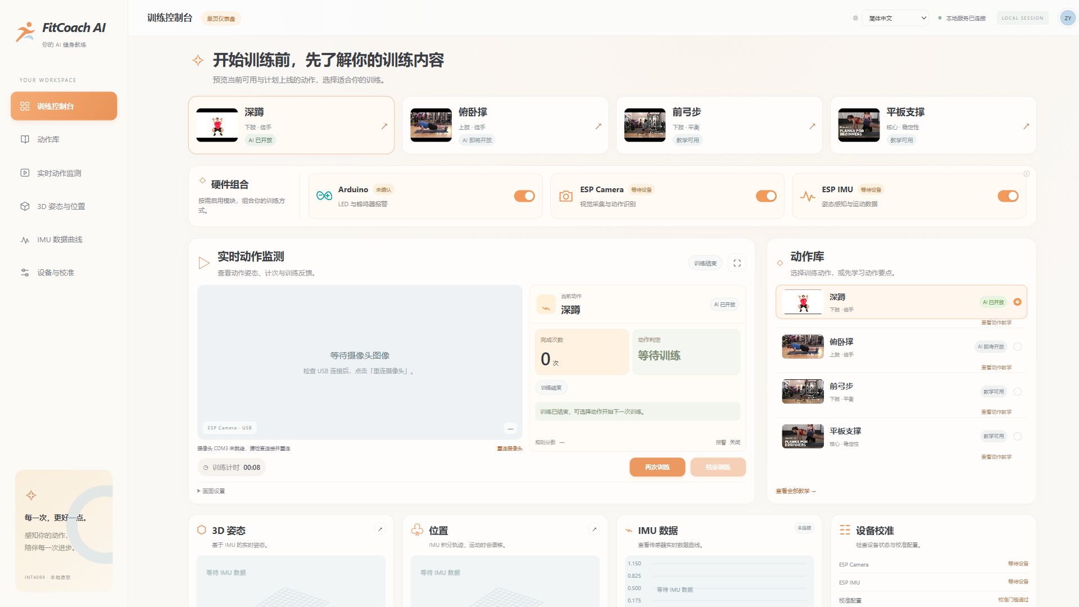
docs/assets/fitcoach-ui-zh-cn-16x9.png
