Steven-ZYC/int4089-fitness-aid-bot/docs/reference/ai-fitness-form-coach.png

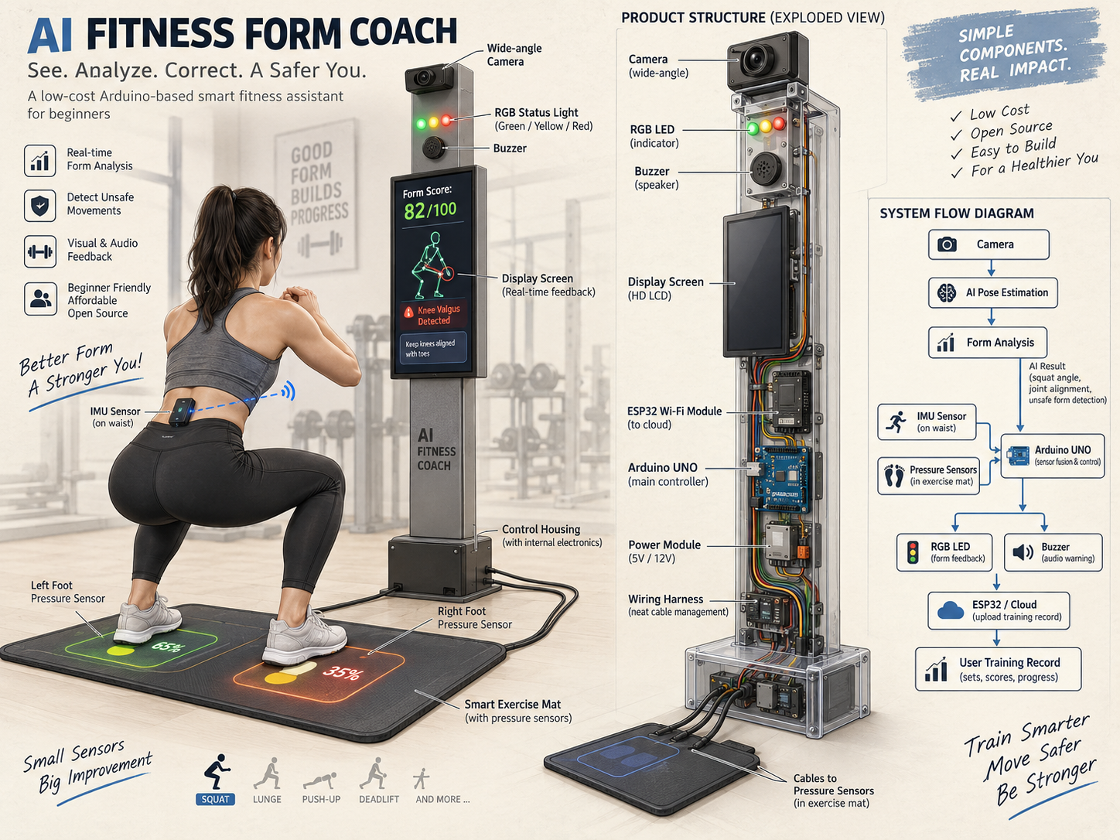
docs/reference/ai-fitness-form-coach.png
