Steven-ZYC/int4089-fitness-aid-bot/firmware/esp32-camera/evidence/2026-11-03/camcheck_20261103_211914_472.jpg

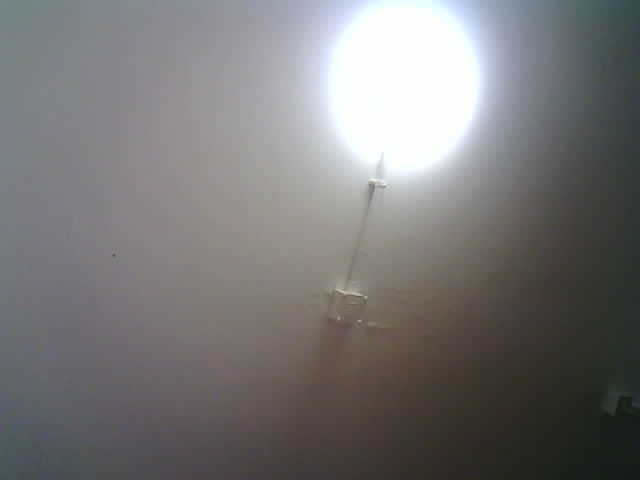
firmware/esp32-camera/evidence/2026-11-03/camcheck_20261103_211914_472.jpg
