Steven-ZYC/int4089-fitness-aid-bot/firmware/esp32-camera/evidence/2026-11-03/camcheck_20261103_212401_166.jpg

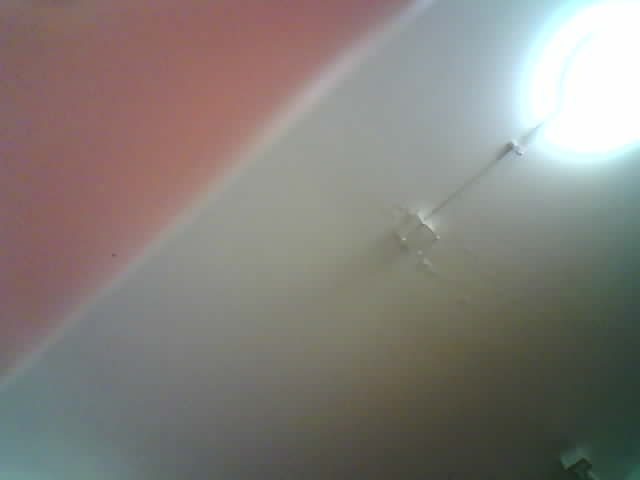
firmware/esp32-camera/evidence/2026-11-03/camcheck_20261103_212401_166.jpg
