Steven-ZYC/int4089-fitness-aid-bot/firmware/esp32-camera/evidence/2026-11-04/dualimage_20261104_003249_291_dropack.jpg

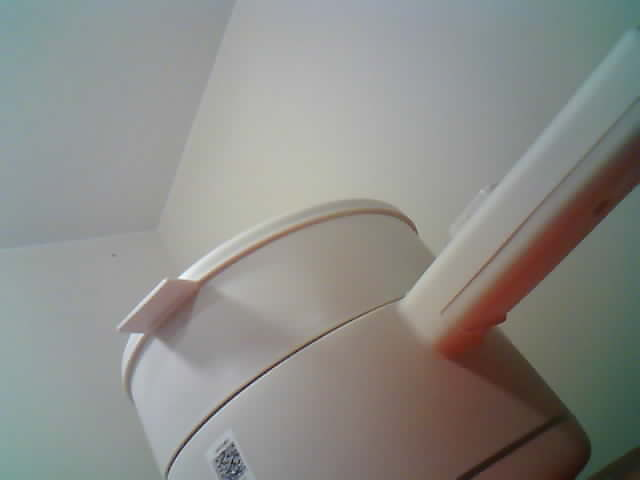
firmware/esp32-camera/evidence/2026-11-04/dualimage_20261104_003249_291_dropack.jpg
