Steven-ZYC/int4089-fitness-aid-bot/firmware/esp32-camera/evidence/2026-11-04/imageimu_20261104_010412_465_normal.jpg

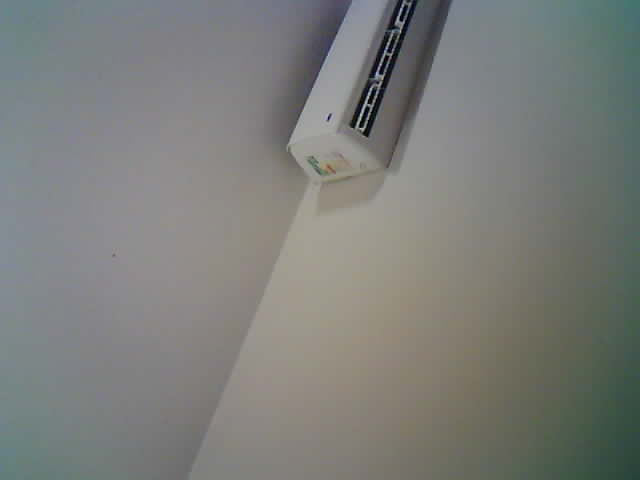
firmware/esp32-camera/evidence/2026-11-04/imageimu_20261104_010412_465_normal.jpg
