Steven-ZYC/int4089-fitness-aid-bot/docs/guide/parts/SOURCES.md

# Component image sources

Downloaded 11 November 2026. Images are external product/identification references, not photos of the project hardware. Source links are embedded beside each image in the PDF. Ownership remains with the original sources; no open licence is asserted.

- cam.jpg: FlyRobo, Ai-Thinker ESP32-CAM with OV2640 product photograph.
- s3.jpg: Elektroweb, ESP32-S3 DevKitC-1 N16R8 product photograph.
- bmi160.jpg: HALJIA, purple BMI160 module product photograph.
- mega.jpg: Arduino official Arduino product photograph.
- usb.jpg: UGREEN France USB connector identification graphic.
- components.jpg: Psytfei component chart, located through manuals.plus/asin/B0D929MYW4.

The manual distinguishes representative boards from verified wiring. Small-component chart extras and quantities are not the project bill of materials.
