Steven-ZYC/int4089-fitness-aid-bot/docs/guide/parts/bmi160.jpg

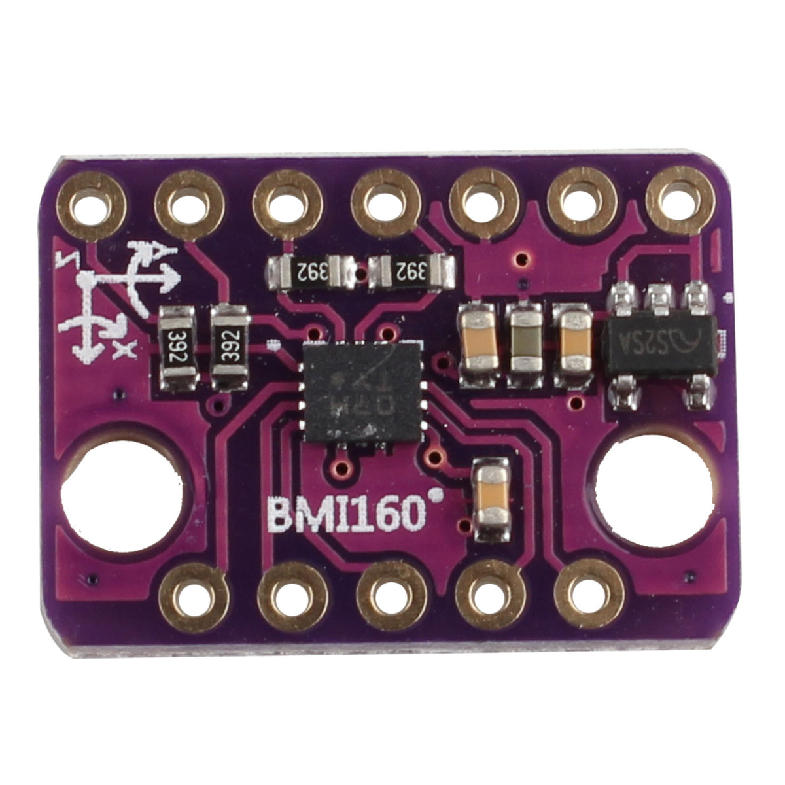
docs/guide/parts/bmi160.jpg
