Steven-ZYC/int4089-fitness-aid-bot/docs/guide/parts/cam.jpg

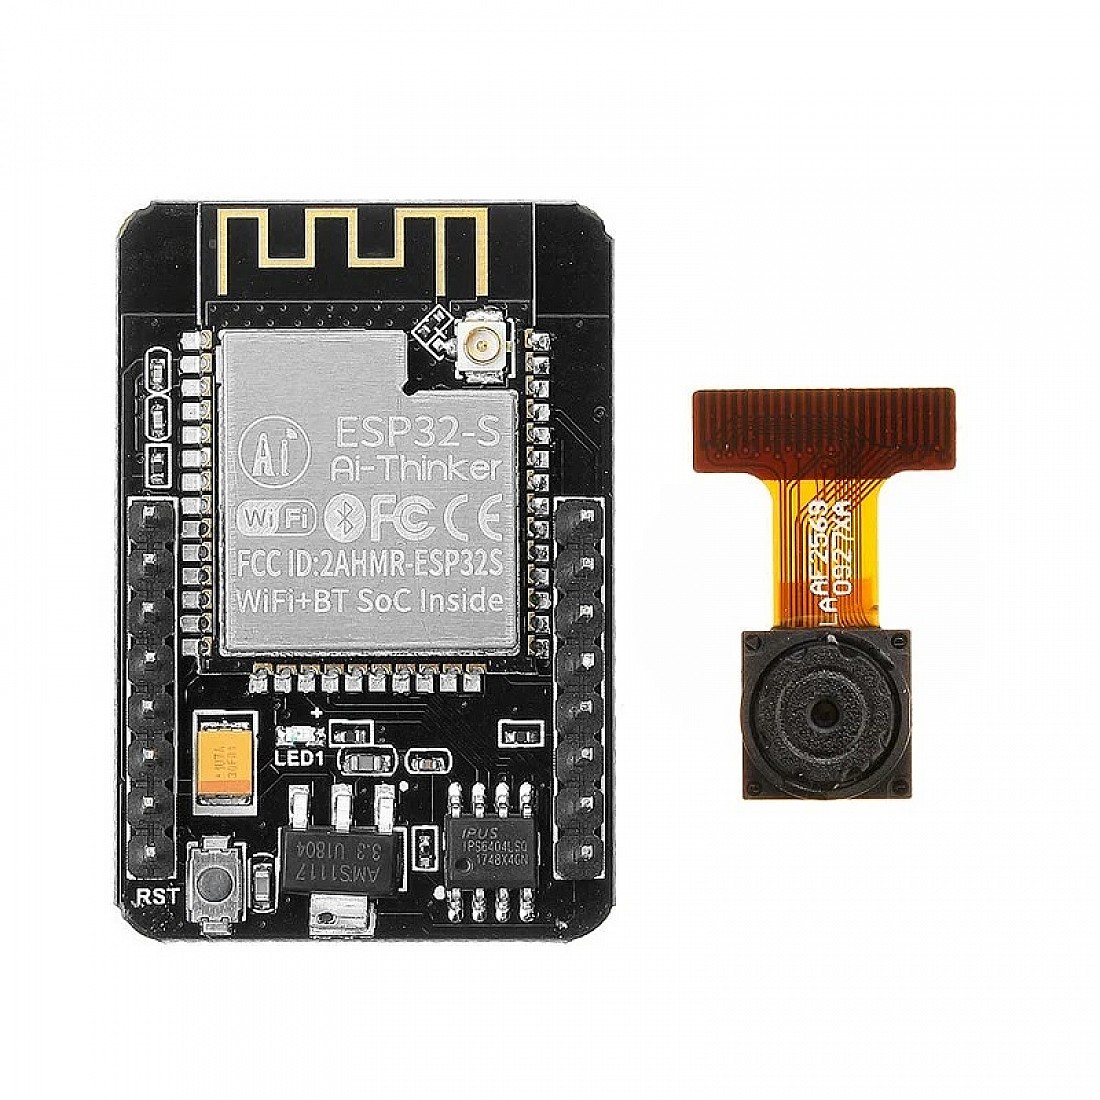
docs/guide/parts/cam.jpg
