Steven-ZYC/int4089-fitness-aid-bot/firmware/esp32-camera/evidence/2026-11-05/bmi160_wiring_front_20261105.jpg

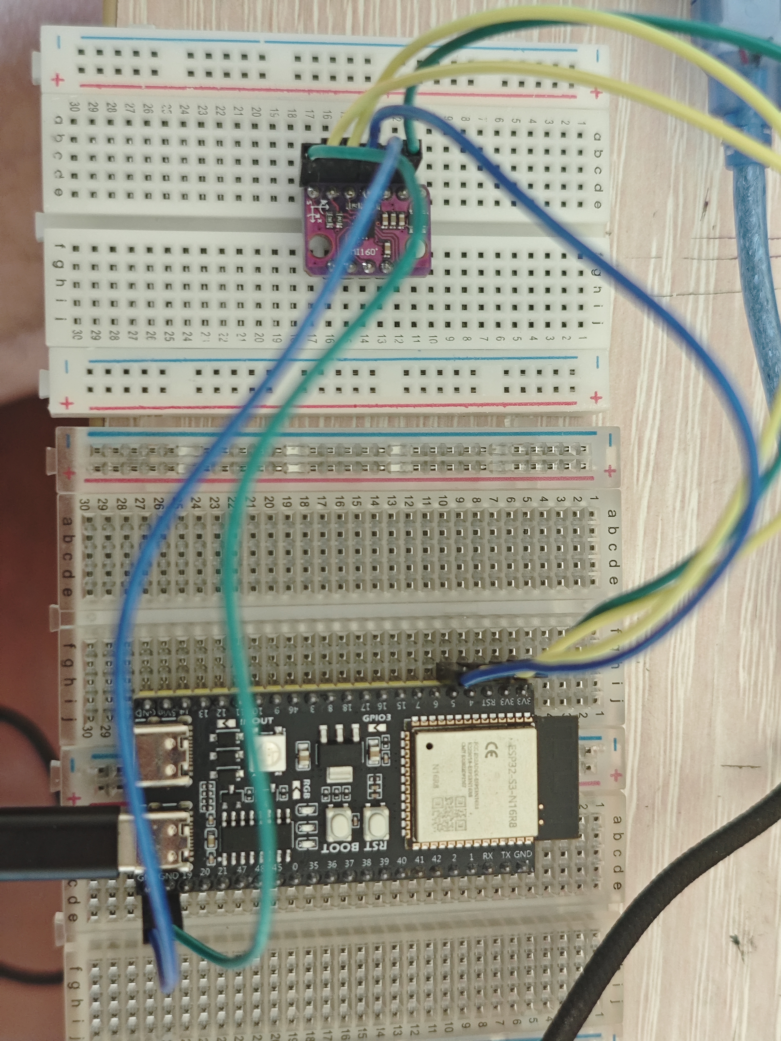
firmware/esp32-camera/evidence/2026-11-05/bmi160_wiring_front_20261105.jpg
