Steven-ZYC/int4089-fitness-aid-bot/firmware/esp32-camera/BMI160_SIX_AXIS_RESULT.md

# 第 3 步實測：六軸串流、靜止與轉動

日期：2026-11-03（Asia/Shanghai）。負責人：Dong Yuankun。分支：`Feat-Esp-Yuankun`。本人分支測試記錄；交付邊界見 [HANDOFF.md](HANDOFF.md)。

**本頁保存最初六軸基線：15 秒靜止與 15 秒自由轉動，各約 49.73 組／秒，接收檢查通過。** 後續照片參考方向、順時針主要負 Z 及電腦端獨立零偏驗證亦已完成，基礎採集驗收通過；完整精密校準等保留項目見 [方向與校準續記](BMI160_AXES_CALIBRATION.md)。

## 器材與程式

- 接法沿用 [六線表](BMI160_WIRING.md)：S3 GPIO4 SDA、GPIO5 SCL；BMI160 3v3 供電、CS 接 3V3、SA0 接 GND、VIN 空接。
- USB 走 CH340 COM9；用戶已確認模組穩放桌上且監視器關閉；第二段按提示緩慢傾斜／轉動。
- 草圖：[BMI160_SixAxis.ino](BMI160_SixAxis/BMI160_SixAxis.ino)，本次通過版本 `BMI160_SixAxis_v2`。
- 工具：[capture_bmi160.ps1](capture_bmi160.ps1)，每段記錄約 15 秒；USB 115200 baud，I²C 100 kHz。
- Arduino CLI 1.5.1、esp32 core 3.3.12、esptool 5.3.1；板卡選項沿用已通過的 S3／16MB／OPI PSRAM／CDC Disabled 設定。
- v2 編譯：程式 308,159 bytes、靜態變數 23,532 bytes；上傳成功，寫入雜湊通過。
- 源碼 SHA256：`55CBA18066AFF9ED452DC7577AA5D1C8A24A2CD67D3BEA322B452B22DB52A895`。
- 應用二進位 308,304 bytes，SHA256：`2548802EC2716A98B7EB17CBBDEA2FF8482E829CE1CA28644005D5C67834F7CB`。

實際配置讀回（兩段各取得三次同樣的配置報告）：

```text
# CONFIG firmware=BMI160_SixAxis_v2 chip_id=0xD1 address=0x68 acc_conf=0x27 acc_range=0x05 gyr_conf=0x27 gyr_range=0x02 pmu=0x14 err=0x00 odr_hz=50 accel_unit=g gyro_unit=deg/s calibrated=NO
```

## 兩段有效記錄

| 指標 | 靜止 v2 | 自由轉動 v2 |
| --- | ---: | ---: |
| 開始時間（Asia/Shanghai，取記錄內 UTC 換算） | 13:25:58.941 | 13:28:25.123 |
| 有效資料列 | 747 | 747 |
| 首尾 S3 讀取時間跨度 | 15.001 s | 15.000 s |
| 實際接收組數／S3 讀取秒數 | 49.7300 Hz | 49.7333 Hz |
| 讀取間隔最小／最大 | 20／21 ms | 20／21 ms |
| 超過 30 ms 的讀取間隔 | 0 | 0 |
| 序號不連續／時間倒退 | 0／0 | 0／0 |
| 格式錯誤／診斷錯誤 | 0／0 | 0／0 |
| 接近 int16 滿量程的資料列 | 0 | 0 |
| 加速度合量均值 | 1.00354 g | 0.99972 g |
| 加速度合量標準差 | 0.00158 g | 0.01337 g |
| 加速度合量最小／最大 | 0.99815／1.00921 g | 0.92652／1.09115 g |

以上頻率用 `(資料列數−1) ÷ 首尾 t_read_us 差` 計算；時間跨度和電腦端設定的 15 秒會因開始／結束讀行邊界略有差異。原型檢查允許 45–55 Hz，但本次列出實際值，不把目標值當測量結果。

### 靜止與轉動如何不同

| 軸 | 靜止平均 | 自由轉動最小～最大 |
| --- | ---: | ---: |
| ax | −0.00731 g | −0.19019～+0.15405 g |
| ay | −0.12519 g | −0.21924～+0.03748 g |
| az | +0.99567 g | +0.92188～+1.08008 g |
| gx | −0.08274 °/s | −22.1951～+20.0610 °/s |
| gy | −0.36629 °/s | −74.4055～+69.2073 °/s |
| gz | +0.26686 °/s | −16.6159～+11.9512 °/s |

這表示六軸串流有合理的靜止基線及明顯的手動運動反應。自由轉動沒有逐軸標記精確的動作時間，因此這一段不能代替逐軸正負方向驗證、標準角速度校驗或停止後回復測試。

## 原始證據

- [靜止 CSV](evidence/2026-11-03/bmi160_stationary_v2.csv)／[靜止統計 JSON](evidence/2026-11-03/bmi160_stationary_v2.json)
- [自由轉動 CSV](evidence/2026-11-03/bmi160_motion_v2.csv)／[自由轉動統計 JSON](evidence/2026-11-03/bmi160_motion_v2.json)

CSV 保留原始六軸及換算欄位，不扣除偏置；欄位定義見 [操作與解讀指南](BMI160_SIX_AXIS.md)。擷取工具為每段保存了診斷文字；以上四個整理後證據檔不含裝置唯一序號或網絡憑證。

## 一次發現並修正的時序問題

初版 v1 在約 15 秒內收到 743 組，約 49.599 Hz，但有三個超過 30 ms 的讀取間隔，最長約 44 ms；其格式、序號及通訊錯誤計數仍為零。每 5 秒的長配置文字加重了同步串口輸出負擔。

v2 在 Serial.begin 前配置 2048-byte 發送緩衝，並移除週期重複的 CSV 標題；同樣保留每 5 秒配置檢查。重測的靜止及轉動記錄均無超過 30 ms 的讀取間隔。初版完整擷取保留在本機輸出目錄，以便追查；它沒有被當成通過結果。

## 偏置與下一個驗收點

靜止時角速度均值約為 `[-0.08274, -0.36629, +0.26686] °/s`，這是本次靜止零偏的候選估計，尚未套用補償。補償概念是 `修正角速度 = 原始換算角速度 − 本軸靜止偏置`；需要用另一段靜止資料驗證效果和暖機穩定性後，才能稱為初步校準。

加速度的靜止三軸包含重力；桌面和模組也沒有嚴格調平，不能把 ay 的 −0.12519 g 全部認定成零偏。其完整校準需要已知方向／姿態的多組量測。

本頁測試後，已另行完成照片參考方向及電腦端獨立零偏驗證，見 [續記](BMI160_AXES_CALIBRATION.md)。下一階段重連 CAM；更長時間記錄、FIFO、跨相機時間對齊、人體固定、精密校準及全系統鏈路仍需後續工作。

本版 `t_read_us` 是 S3 讀取前的時間；BMI160 的 `sensor_ticks` 是另一時鐘域。兩者未與相機或電腦同步。序號連續表示這段 USB 資料行連續，不構成晶片內部零丟樣證明。
