Steven-ZYC/int4089-fitness-aid-bot/firmware/esp32-camera/DUAL_ESP_TEXT_RESULT.md

# CAM ↔ S3 無線文字實測：2026-11-03

身份：Dong Yuankun。分支：`Feat-Esp-Yuankun`。下列時間為 UTC+8，原始 JSON 保留 UTC。交付與目前未完成項目見 [HANDOFF.md](HANDOFF.md)。

**雙向文字往返及漏 ACK 重試通過。** 正常案例兩個方向各 20／20 次，沒有重試或失敗；再各故意漏一個應用層回覆，均重試一次後成功，接收端辨認了重複序號。這完成第 4 步的文字小步；圖像分片／重組仍待實作。操作與原理見 [DUAL_ESP_TEXT.md](DUAL_ESP_TEXT.md)，當前總進度見 [PROGRESS.md](PROGRESS.md)。

## 測試條件與當前固件

| 項目 | 本輪條件 |
| --- | --- |
| CAM | ESP32-D0WD-V3，CH340 COM11；USB 串口 115200、CDC Disabled |
| S3 | ESP32-S3，換回 CH340 COM 接口後為 COM9；USB CDC On Boot Disabled |
| 無線 | ESP-NOW，兩板 INFO 實際讀回頻道 1；48 bytes／包，CRC32，未加密的固定測試文字 |
| 配對 | 項目 magic／協議版本／相反角色發現，位址只存 RAM；工具交叉核對對方開機編號與實際連接的另一塊板 |
| 執行環境 | Arduino CLI 1.5.1，Espressif core 3.3.12／IDF v5.5.5，Windows PowerShell 雙端記錄 |
| 正式完整測試時間 | 22:20:16.868–22:20:28.358；工具總耗時約 11.430 秒，包含配對檢查、4 組測試及讀狀態 |
| 物理環境 | 用戶現有桌面擺放，兩塊板各由 USB 連接電腦；板間沒有新增信號線，距離未量測 |

兩塊板現在運行 [DualESP_Text_Check_v1](DualESP_Text_Check/DualESP_Text_Check.ino)，`acquisition=OFF`；本自檢沒有讀相機或 IMU 資料。之前成功的相機及六軸草圖保留，之後須把採集功能和通信整合並重測。測試結束後電腦已關閉兩個串口，板上不再執行 RUN，仍保留診斷用 HELLO／週期狀態。

電腦只發 `INFO`、`RUN`、`DROP_NEXT_ACK` 控制命令並讀日誌，沒有將 CAM 的資料透過電腦轉發給 S3。接收板 `APP_RX` 和發送板 `APP_ACK` 的內容、序號、雙方開機編號由工具逐條配對。

## 完整通過的四組案例

往返時間以發送板本身的單調時鐘，從第一次無線發送到收到匹配的應用層 ACK 計算。故意漏 ACK 的約 1 秒等待單獨列出；不當作正常短訊息延遲。

| 方向／案例 | 邏輯訊息 | ACK 成功 | 失敗 | 重試 | 往返平均 | 最小–最大 |
| --- | ---: | ---: | ---: | ---: | ---: | --- |
| S3 → CAM，正常 | 20 | 20 | 0 | 0 | 5.043 ms | 4.026–6.013 ms |
| CAM → S3，正常 | 20 | 20 | 0 | 0 | 4.075 ms | 3.994–4.994 ms |
| S3 → CAM，故意漏 ACK | 1 | 1 | 0 | 1 | 1005.624 ms | 單次 |
| CAM → S3，故意漏 ACK | 1 | 1 | 0 | 1 | 1004.714 ms | 單次 |

合計 42 條邏輯訊息全部有接收端記錄及對應回覆；PING 發送嘗試為 44 次，另外還有 HELLO 和 ACK 無線包。正常序號 S3 為 21–40、CAM 為 1–20；故意漏回覆案例分別為 S3 的 41、CAM 的 21。

兩個故障案例均記錄 `FAULT_DROP_ACK`，發送端重試相同序號，接收端 `duplicate=1` 並補回 ACK；每個方向只增加 1 條唯一訊息，不把重試當作新訊息。CRC 錯誤、非法欄位、收／發佇列丟失、發送 API 錯誤及無線底層失敗計數在完整測試中均為零。

CAM 的完整測試前已收到上一輪工具中斷測試的 20 條訊息，所以原始累計計數不是從零開始。完整測試前後 CAM 唯一接收數 20 → 41，S3 為 0 → 21；各增加 21。重複接收各 0 → 1，符合故意漏 ACK 的設計。沒有把上一輪 20 條混進正式 42 條統計。

完整原始證據：

- [通過報告及 42 條逐次往返統計](evidence/2026-11-03/dualtext_20261103_222016_868.json)。
- [CAM 原始串口記錄](evidence/2026-11-03/dualtext_20261103_222016_868_CAM.txt)。
- [S3 原始串口記錄](evidence/2026-11-03/dualtext_20261103_222016_868_S3.txt)。

## 構建與上傳證據

CAM 和 S3 使用不同的 ASCII 暫存來源目錄，各自編譯，檢查映像目標後才依序上傳。兩個最終版本都回報 `Hash of data verified`。

| 版本 | 程式／靜態變數 | bin bytes | 應用 bin SHA256 |
| --- | --- | ---: | --- |
| CAM／COM11 | 919,636／46,040 bytes | 919,792 | `A801FDD23C2495D2C478B94F74C60460E6D787E86573B68A7CF9C968F0900F73` |
| S3／COM9 | 875,858／45,220 bytes | 876,000 | `94932BE9274E91833F61B89B74BD0AA92CCDF567160E13EDE7F319B79B12DFEF` |

共用草圖 SHA256：`E8A3EAAB4F3824C8A4BB57C112CC76AEF6CDDF3778DF64A03482778BDD07F607`。

通過測試工具 SHA256：`4B7E2FB6E31BDBB0BF9E820783FF1D8C9D766B5AB49655B7EAA18EBE1C091BB0`。

[構建／FQBN／上傳摘要](evidence/2026-11-03/dualtext_build_upload_20261103.json)、[CAM 上傳日誌](evidence/2026-11-03/dualtext_cam_upload.txt)、[S3 COM 上傳日誌](evidence/2026-11-03/dualtext_s3_com_upload.txt)。日誌已過濾裝置唯一位址。

## 之前兩次未完整通過的嘗試

1. **22:04，原生 USB 嘗試。** S3 原生 COM10／CDC Enabled 固件上傳有校驗通過，但工具 20 秒等待期間沒有收到 S3 的串口輸出，CAM 也未配對；沒有進入應用層訊息案例。後續換回已驗證的 CH340 COM9，使用 CDC Disabled。原生 USB 無輸出的根本原因未定位，不將它寫成 ESP-NOW 不支援。保留 [失敗 JSON](evidence/2026-11-03/dualtext_20261103_220443_644.json) 及 [CAM 記錄](evidence/2026-11-03/dualtext_20261103_220443_644_CAM.txt)；當時 S3 沒有任何文字，舊工具未產生空日誌，沒有補造串口內容。
2. **22:18，電腦統計工具中斷。** S3 → CAM 的 20 次已在板端回覆，工具在 `Measure-Object` 讀取有序字典屬性時出錯，因此整次報告維持 `pass=false`。改成先提取純數值再計算，然後重跑完整四組。保留 [失敗 JSON](evidence/2026-11-03/dualtext_20261103_221842_836.json)、[CAM 記錄](evidence/2026-11-03/dualtext_20261103_221842_836_CAM.txt)、[S3 記錄](evidence/2026-11-03/dualtext_20261103_221842_836_S3.txt)。

## 驗收邊界與下一步

本輪通過的是桌面條件下、48-byte 測試文字的應用層雙向往返，以及單次漏 ACK 的重試／重複辨認。未測試達到最大重試次數後的恢復、惡意資料／身份認證、加密、節點重啟恢復、距離／遮擋／干擾、連續圖片速度、圖像分片、Wi-Fi 聯網共存或 AI／Arduino 控制。上述毫秒數不能當作一張照片或 AI 的端到端延遲。

下一個小步驟：恢復 CAM 取單張 JPEG，經無線分片送到 S3 重組，再由電腦核對圖片大小、內容校驗和解碼。相機與 IMU 同時工作、聯網及跨板時間對齊須在整合階段再測。
