Steven-ZYC/int4089-fitness-aid-bot/experiments/yancheng/esp32-pose-bench/results/2026-10-23-classic-esp32.md

# 2026-10-23：经典 ESP32-CAM 板端实测

测试人：Zhang Yancheng。时区：Asia/Hong_Kong（UTC+8）。

**128×128、INT8 YOLO11n-Pose 已在本板执行完成 10 帧：纯推理约 15.126 秒／帧，0.0661 FPS；完整取帧处理吞吐约 0.0655 FPS。当前配置无法用于实时纠姿。** 这不是 S3 官方基准，也不是电脑上的推理结果。

## 硬件及模型

| 项目 | 实测或本次构建配置 |
| --- | --- |
| 芯片 | ESP32-D0WD-V3，revision v3.1；固件读到 revision=301 |
| CPU | 双核，实际时钟 240 MHz；ESP-DL 运行模式 AUTO，未单独测量各核心利用率 |
| Flash | 4,194,304 字节（4 MiB） |
| PSRAM | 物理容量及映射容量均为 **2,097,152 字节（2 MiB）** |
| 相机 | 160×120、RGB565BE、单帧缓冲；传感器 PID 读数为 38 |
| 引脚 | Yuankun 工作草图中的 AI Thinker 配置 |
| 时钟配置 | Flash DIO 40 MHz；PSRAM 40 MHz；相机 XCLK 20 MHz |
| 模型 | YOLO11n-Pose，自定义 128×128，W8A8 / INT8，量化 target=c |
| 权重策略 | 权重留在 Flash，避免将约 3.1 MB 权重整体复制到只有 2 MB 的 PSRAM |
| 模型大小 | 3,100,144 字节 |
| 模型 SHA256 | `63b5a91e903789b924a58c3b49335533e73a97e4348bfa4e74f741847e29e96e` |
| Pose 应用镜像 | 3,921,440 字节，应用分区容量 4,128,768 字节 |
| 软件 | ESP-IDF v5.5.2；ESP-DL 3.3.14；esp32-camera 2.1.5 |
| 量化工具 | torch 2.7.1+cpu；ultralytics 8.3.162；esp-ppq 1.3.12；onnx 1.19.1 |
| 校准 | 官方 COCO8-Pose 的 8 张图，仅用于链路与速度实验，未验证姿态精度 |

## 实际计时

两个模式均预热 2 帧并丢弃预热计时，随后收集 10 帧。下表不是两种尺寸模型的对比，`camera_only` 没有运行神经网络。

| 指标 | 仅相机基线 | 板端 Pose |
| --- | ---: | ---: |
| 平均取帧耗时 | 148.6125 ms | 124.1226 ms |
| 平均预处理耗时 | 不适用 | 13.0447 ms |
| 平均神经网络推理耗时 | 不适用 | **15125.6437 ms** |
| 神经网络推理 P95 | 不适用 | 15125.7020 ms |
| 平均后处理耗时 | 不适用 | 0.7561 ms |
| 纯推理 FPS | 不适用 | **0.0661129** |
| 从第一帧开始到最后一帧完成的处理 FPS | **6.26036** | **0.0654750** |
| Pose 循环中的剩余 PSRAM | 不适用 | 1,827,612 字节 |

Pose 的 10 帧神经网络执行总时间为 151.256437 秒，采样区间为 152.730163 秒。吞吐使用 `帧数 / 总时间`，不是逐帧 FPS 的平均值。处理 FPS 包含帧间串口日志和调度间隔，不包含 PC 绘制、联网传输或完整曝光到显示延迟。

| 帧号 | 纯推理耗时（ms） | 检测人数 |
| --- | ---: | ---: |
| 0 | 15125.658 | 0 |
| 1 | 15125.672 | 0 |
| 2 | 15125.680 | 0 |
| 3 | 15125.639 | 0 |
| 4 | 15125.638 | 0 |
| 5 | 15125.676 | 0 |
| 6 | 15125.538 | 0 |
| 7 | 15125.616 | 0 |
| 8 | 15125.618 | 0 |
| 9 | 15125.702 | 0 |

**10 帧全部未检测到人体。** 本次没有归档现场画面，没有验证相机颜色与模型输入的匹配、关键点准确度或低分辨率量化后的检测质量；不能据此宣称模型已能正确识别人或判断动作。零候选下的后处理耗时也不能代表有人画面中的全部后处理开销。

本次证明的是模型能够装入并在该板执行、计时和完成后处理。相机可运行而 Pose 极慢，耗时主要位于网络执行阶段；不能把 6.26 的相机 FPS 宣称为姿态估计帧率。本配置优先节省 PSRAM，未证明它是本芯片上的最快实现。96×96、不同 Flash 时钟和其他内存／核心策略仍需另测，不能按像素比例推算 FPS。

仅采样 10 帧，P95 按最近秩计算，未进行长时间稳定性测试。

## 复现和原固件恢复

- 代码及执行顺序见上级 [README](../README.md)。本次使用 `--size 128 --calib-steps 8`。
- 本地原始记录在 `local/20261023_184055_probe.json`、同名 `.log`，以及 `local/20261023_184317_pose.json`、同名 `.log`；这些原始日志由 Git 忽略。本文件只提交不包含图像或关键点个人记录的技术统计。
- 测试前完整读取 4 MiB Flash；备份 SHA256 为 `8864c8a8eae8c6be29b7c7c2ca81edd02053bd8471c59f1a2508b9fafdb9d34f`，备份文件保存在本地 `artifacts/backups/20261023_183722/original.bin`。
- CH340 在首次 460800 baud 备份中断时尚未烧录；降低到 230400 后完成备份与测试。
- 两次测试均已恢复原固件；Pose 测试后再次在板上校验整片 Flash 与备份一致，并观察到原相机程序的 `READY`。
- Python 统计契约的 4 项测试通过，覆盖整体吞吐算法、相机／推理模式区分、缺帧／复位／异常计时，以及无样本情况。这些合成测试与上面的板端实测分开记录。
