Steven-ZYC/int4089-fitness-aid-bot/firmware/esp32-camera/evidence/2026-11-03/bmi160_gyro_validation_rest.csv

sample_seq | t_read_us | sensor_ticks | ax_raw | ay_raw | az_raw | gx_raw | gy_raw | gz_raw | ax_g | ay_g | az_g | gx_dps | gy_dps | gz_dps
58300 | 1174179360 | 13082637 | -259 | -781 | 8186 | -2 | -25 | 17 | -0.03162 | -0.09534 | 0.99927 | -0.0305 | -0.3811 | 0.2591
58301 | 1174200360 | 13083172 | -274 | -794 | 8199 | 0 | -25 | 17 | -0.03345 | -0.09692 | 1.00085 | 0.0000 | -0.3811 | 0.2591
58302 | 1174220360 | 13083681 | -258 | -800 | 8192 | -4 | -23 | 16 | -0.03149 | -0.09766 | 1.00000 | -0.0610 | -0.3506 | 0.2439
58303 | 1174240360 | 13084190 | -260 | -779 | 8183 | -7 | -26 | 17 | -0.03174 | -0.09509 | 0.99890 | -0.1067 | -0.3963 | 0.2591
58304 | 1174260360 | 13084699 | -259 | -770 | 8191 | -3 | -24 | 15 | -0.03162 | -0.09399 | 0.99988 | -0.0457 | -0.3659 | 0.2287
58305 | 1174280360 | 13085209 | -258 | -786 | 8180 | -8 | -24 | 19 | -0.03149 | -0.09595 | 0.99854 | -0.1220 | -0.3659 | 0.2896
58306 | 1174300360 | 13085718 | -258 | -785 | 8188 | -7 | -22 | 18 | -0.03149 | -0.09583 | 0.99951 | -0.1067 | -0.3354 | 0.2744
58307 | 1174320360 | 13086227 | -259 | -803 | 8195 | -5 | -26 | 17 | -0.03162 | -0.09802 | 1.00037 | -0.0762 | -0.3963 | 0.2591
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
