Steven-ZYC/int4089-fitness-aid-bot/(commit log)

2026-10-23 feat(esp32): archive offline USB camera demo and photos
2026-10-23 revert: move misplaced Arduino demo to Haoyu feature branch
    This reverts commit 00020982e7b52ec1f62c9b2703b6ed9fde93374b.
    The original work is preserved on Feat-Arduino-Haoyu as 361af7985330452deb27e783879ca217c563dedb, including the original author, author date and source commit reference.
2026-10-23 feat: add classic ESP32 pose benchmark and measured device timings
    [partitions.csv]
2026-10-30 docs: explain post-consultation dual-ESP off-board AI architecture
2026-10-30 docs: align AGENTS.md with computer-side AI and dual ESP32 roles
2026-10-30 docs: align models/README.md with computer-side AI and dual ESP32 roles
2026-10-30 docs: align firmware/esp32-camera/README.md with computer-side AI and dual ESP32 roles
2026-10-30 docs: align firmware/arduino-uno/README.md with computer-side AI and dual ESP32 roles
2026-10-30 docs: fix pose result return path in data flow diagram
2026-11-05 feat(esp32): hand off camera and IMU work with diagnostic evidence
    Archive verified S3, camera, six-axis, ESP-NOW and Wi-Fi control checks.
    Record the current BMI160 initial-ID failure and request leader hardware support.
    Keep image/IMU Wi-Fi transfer, long-run tests and AI/Uno integration incomplete.
    Preserve evidence bytes and include source fingerprints and reproduction guides.
    Validation: 11 PowerShell parsers, 40 evidence JSON files, local Markdown links,
    baseline source hashes and evidence byte preservation; photos and secrets reviewed.
    [bmi160_axes_far_edge_up.csv, bmi160_axes_flat.csv, bmi160_axes_right_edge_up.csv, bmi160_gyro_bias_check.csv, bmi160_gyro_validation_rest.csv, bmi160_motion_v2.csv, bmi160_photo_frame_clockwise.csv, bmi160_photo_frame_end1_up.csv]
2026-11-05 fix(imu): reproduce BMI160 sampling with automatic I2C address detection
    [capture.csv]
2026-11-05 feat(imu): zero-drift profile, serial reader and Windows position panel
    [__main__.py, calibration.py, csvio.py, pipeline.py]
2026-11-06 feat(app): add PC-side realtime pose detection service
    电脑端 AI 推理流程第一版：ESP32-CAM 只负责采集推流，YOLOv8n 在电脑上推理，
    浏览器查看实时画面与检测结果。
    - app.py: HTTP 服务 + MJPEG 推流 + 推理管线，用帧序号去重，避免对同一帧重复推理
    - sources.py: 本地摄像头与 ESP32 MJPEG 流两种视频源，强制直连以绕过系统代理
    - detector.py: YOLOv8n / OpenCV HOG 可切换
    - find_camera.py: 扫描局域网定位 ESP32-CAM 的流地址
    - firmware/esp32_cam_stream: 打通链路的临时推流固件；
    正式采集固件由 Dong Yuankun 在 firmware/esp32-camera/ 负责，本件可被替换
    实测 2026-11-06, RTX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
2026-11-06 feat(app): add realtime exercise form assessment
    在人体检测之上补上「动作做得规不规范」的判断，对应 Haoyu 职责里的
    姿势判断与反馈数据结构。
    链路：YOLOv8n-pose（17 个 COCO 关键点）→ 关节角度 → 阈值规则 → 判决 + 计次
    - pose_engine.py: 姿态估计封装，多人场景取最大包围盒
    - form_rules.py: 膝角/肘角/躯干倾角/左右差计算；深蹲、俯卧撑规则；计次状态机
    - pose_app.py: 判定入口，网页 UI 叠加骨架、角度与判决；与 app.py 共用 sources.py
    - test_rules.py: 用合成关键点测规则引擎，不依赖摄像头（6 项全部通过）
    设计取舍：用几何规则而非端到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
2026-11-10 feat(firmware): establish modular S3-to-Mega alarm control baseline
    Add ESP32-S3 UART test sender and Mega USB/UART alarm receiver with three-digit source/state/XOR frames, PC priority and heartbeat timeout.
    Separate firmware module entry points, document electrical limits and compile/upload steps, preserve existing BMI160 acquisition sources, and record real serial validation. Update architecture and maintenance rules for Yancheng's unified ownership.
2026-11-10 perf(camera): preserve verified 9 FPS USB pipeline and organize architecture
    Use 921600 baud, VGA JPEG quality 18, latest-frame double buffering and batched host requests. Expose transport timing metrics and add before/after benchmarks and wireless control regression evidence.
    Organize current firmware/app/protocol entry points, add a repeatable PowerShell launcher, and distinguish historical experiments from active modules. Preserve the known BMI160 failure and pending physical acceptance scope.
    [Cam_USB_Bridge.ino, benchmark_usb.py, pose_app.py, serial_camera.py, sources.py]
2026-11-10 fix: recover live camera stream and synchronize overlay language
    [main.py, pose_app.py, serial_camera.py, test_camera_recovery.py, test_localization.py]
2026-11-10 docs: add illustrated FitCoach assembly guide and user manual
2026-11-11 docs: standardize Arduino naming and update main development policy
2026-11-11 docs: update assembly manual with verified IMU operation
2026-11-12 Improve README wordings
    Updated important note about the prototype status.
